LeftRadio/neil-scope3/.doc/NeilScope_v3_protocol_L.pdf

# Neil Scope 3

### формат данных и протокол обмена (data format and interface protocol)

Протокол обмена цифрового запоминающего осциллографа NeilScope v3 является полудуплексным сетевым протоколом. Обмен строится по принципу Master/Slave. Осциллограф всегда работает в режиме «Slave», отвечая на запросы программы. Запросы программы и ответы осциллографа передаются кадрами. Очередной кадр передается только после приема подтверждения на передачу предыдущего кадра.

### Структура передаваемого кадра

Передаваемый кадр имеет следующую структуру:

Признак начала кадра | Код команды | Размер кадра(*) | Данные, макс. длинна пакета Nmax = 255 | CRC8
0x5B | 8 бит | 8 бит | N * (8 бит) | 8 бит

Размер кадра включает только размер данных без кода команды и без байта контрольной суммы (CRC). Каждый посылаемый и принимаемый кадр начинается с 0x5B. Содержимое кадра представляет собой последовательность байт от 0x00 до 0xFF. Контрольная сумма представляет собой однобайтовый циклический избыточный код (CRC).

В ответ на команды программы осциллограф посылает пакет, с результатом выполнения команды:

Тип ответа

Признак
начала
кадра
| | Код ответа | Размер кадра(*) | Данные, Nmax = 256(*) | CRC8
Успешно | 0x5B | код команды + 0x40 | 8 бит | N х (8 бит) | 8 бит
Ошибка | 0x5B | 0x7F | 8 бит | 8 бит – Код ошибки | 8бит

(*) для команды запроса данных с осциллографа размер кадра состоит из 3 байт и Nmax = 262144.
Пример запроса программой 32125 точек – 0x5B 0x30 0x1F 0x5F 0x40 0x01 CRC8, где 0х30 это команда запрос данных, 0x1F 0x5F 0x40 три байта размера кадра с левым выравниванием, 0х01 – канал В.
Коды ошибок: | 0х01 | – | ошибка CRC
0x02 | – | ошибка данных
0x03 | – | команда правильная, занят, повтори

### Тайминги обмена

После запроса на инициализацию обмена хост должен выдержать паузу не менее чем 500мс перед следующим запросом, эта задержка нужна для процедуры инициализации осциллографа и перехода его к работе с ПК, в дальнейшем, перед последующими запросами выдерживать эту паузу не нужно. Ответ осциллографа на любые запросы должен прийти не позже чем через 100мс, исключение — ответ на запрос данных(см. команду Запрос данных с осциллографа), запрос перехода в режим загрузчика. После команды завершения обмена с осциллографом следующая команда с ПК, например на повторную инициализацию, не должна прийти ранее чем через 7сек.

### Расчет CRC

В расчет CRC включается содержимое кадра (байты 1…N). Кроме этого передатчик в расчет CRC включает дополнительно один нулевой байт. Приемник включает в подсчет CRC кроме содержимого кадра один байт контрольной суммы (байт N+1). При правильном приеме кадра результирующее CRC должно быть равно 0.

Алгоритм расчета CRC:
1. Значение переменной CRC приравнивается к 0x00.
2. Циклически для каждого байта, участвующего в расчете CRC, вызывается функция CRC8.
3. На вход функции CRC8 подается значение очередного байта и текущее значение CRC. Функция возвращает пересчитанное значение CRC, с учетом поданного на вход байта.
4. После вызова функции CRC8 для всех байтов на вход функции посылаем 0x00 в качестве очередного байта и текущее значение CRC
5. Получаем результирующее значение CRC.

Код используемой функции расчета CRC8

unsigned char CRC8(unsigned char byte, unsigned char crc) {
int i ;
for ( i = 0; i < 8 ; i++)
{
if (crc & 0x80) {
crc<<=1;
if (byte & 0x80) сrc = crc | 0x01;
else crc = crc & 0xfe;

crc = crc ^ 0x85;
}
else {
crc<<=1;
if (byte & 0x80) crc = crc | 0x01;
else crc = crc & 0xfe;
}
byte <<=1;
}
return (crc);
}

### Инициализация/завершение обмена

Для инициализации режима работы осциллографа совместно с программой, программа посылает на осциллограф код команды инициализации обмена и VID устройства. Получив команду, осциллограф переключается в режим управления от программы и посылает подтверждение. (см. Тайминги обмена)
После успешной инициализации программа должна сконфигурировать осциллограф - установить делители, уровень развертки, триггеров и т.д. При получении команды на завершение обмена осциллограф переключается в автономный режим работы и возвращает все параметры которые были установлены ранее в автономном режиме.

### Список управляющих команд

Значение
HEX

Комментарий

0х81 | Инициализации обмена
0хFC | Завершения обмена
0x09 | Переключение режима осциллограф / логический анализатор
0x10 | Включение/отключение аналоговых каналов и управление открытый/закрытый вход (только осциллограф)
0х11 | Управление аналоговыми делителями вертикальной развертки (только осциллограф)
0x12 | Запрос на калибровку нуля аналоговых каналов (только осциллограф)
0х14 | Режим синхронизации (только осциллограф)
0x15 | Источник триггера
0х16 | Управление типом триггера
0x17 | Уровень «UP» триггера
0x18 | Уровень «DOWN» триггера
0х19 | Управление курсором триггера по Х
0x20 | Битовая маска “перепада” триггера ЛА
0x21 | Битовая маска “состояния” триггера ЛА
0x25 | Управление горизонтальной разверткой
0x27 | Переключение режима записи - DEFAULT, MIN/MAX(только ОСЦ), INTERLIVE(только ОСЦ), RLE(только ЛА)
0x30 | Запрос данных каналов
0х0А | Запрос напряжения аккумулятора
0xEE | Запрос на сохранение всех настроек в EEPROM
0хВ0 | Запрос на переход к загрузчику
0x00 | Запрос версии прошивки

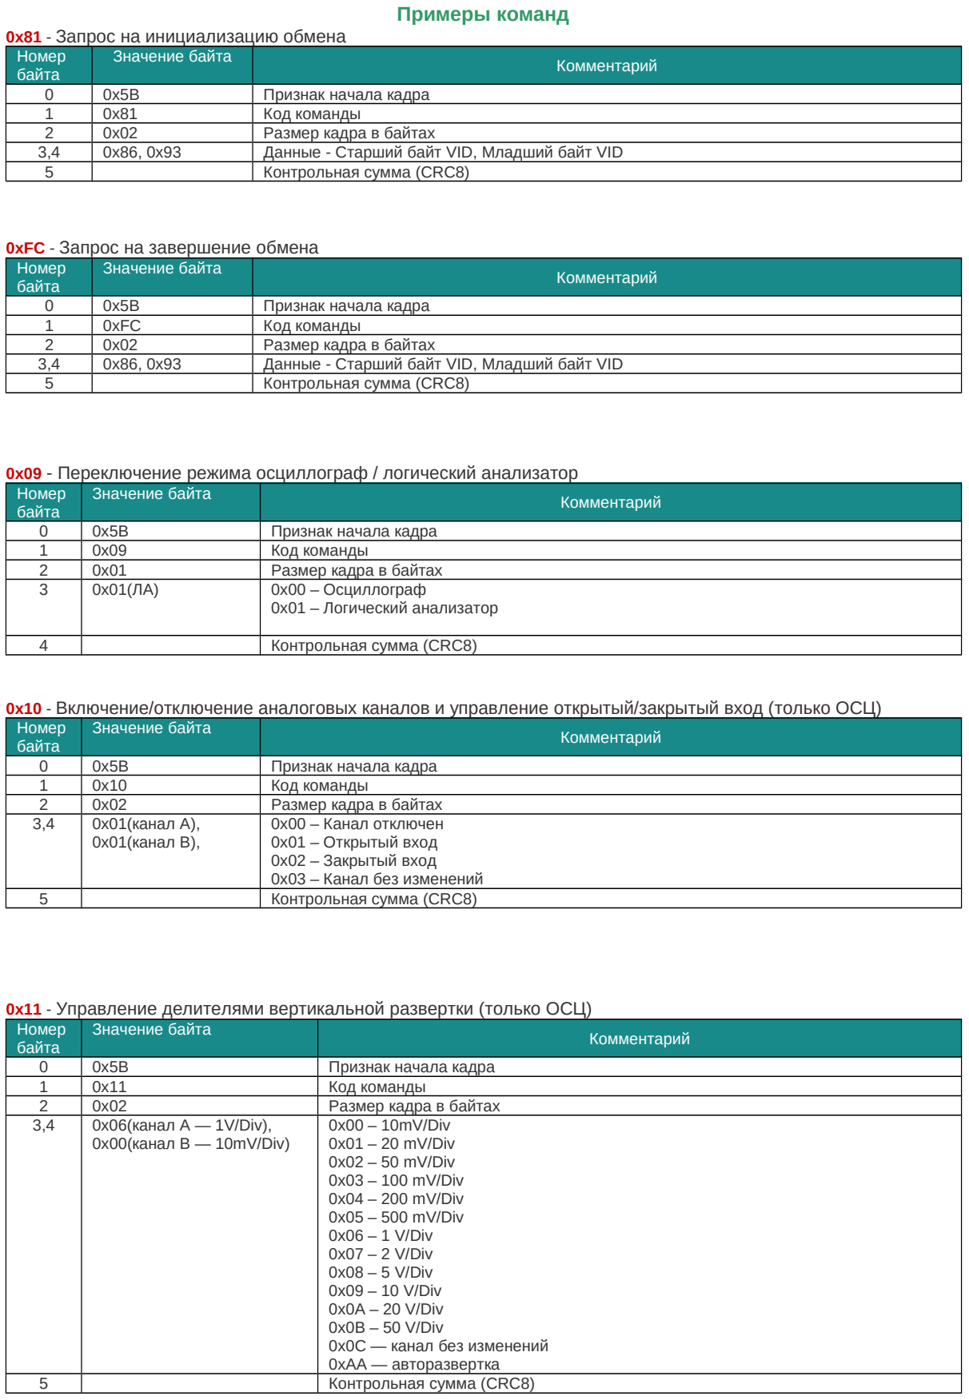
[picture p1: figure]
Примеры команд; 0х81 - Запрос на инициализацию обмена Номер байта; Значение байта; Комментарий; Признак начала кадра; Код команды; Размер кадра в байтах; Контрольная сумма (CRC8); 0хFC - Запрос на завершение обмена Номер байта; 0хFC; Номер байта; 0х00 – Осциллограф; 0х01 – Логический анализатор; 0x01(канал A),; 0x01(канал B),; 0х00 – Канал отключен 0х01 – Открытый вход 0х02 – Закрытый вход 0х03 – Канал без изменений; 0x06(канал А — 1V/Div),; 0х00(канал В — 10mV/Div)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

3,4 | 0x86, 0x93 | Данные - Старший байт VID, Младший байт VID
3,4 | 0x86, 0x93 | Данные - Старший байт VID, Младший байт VID

0x09 - Переключение режима осциллограф / логический анализатор

0x10 - Включение/отключение аналоговых каналов и управление открытый/закрытый вход (только ОСЦ)

0x11 - Управление делителями вертикальной развертки (только ОСЦ)

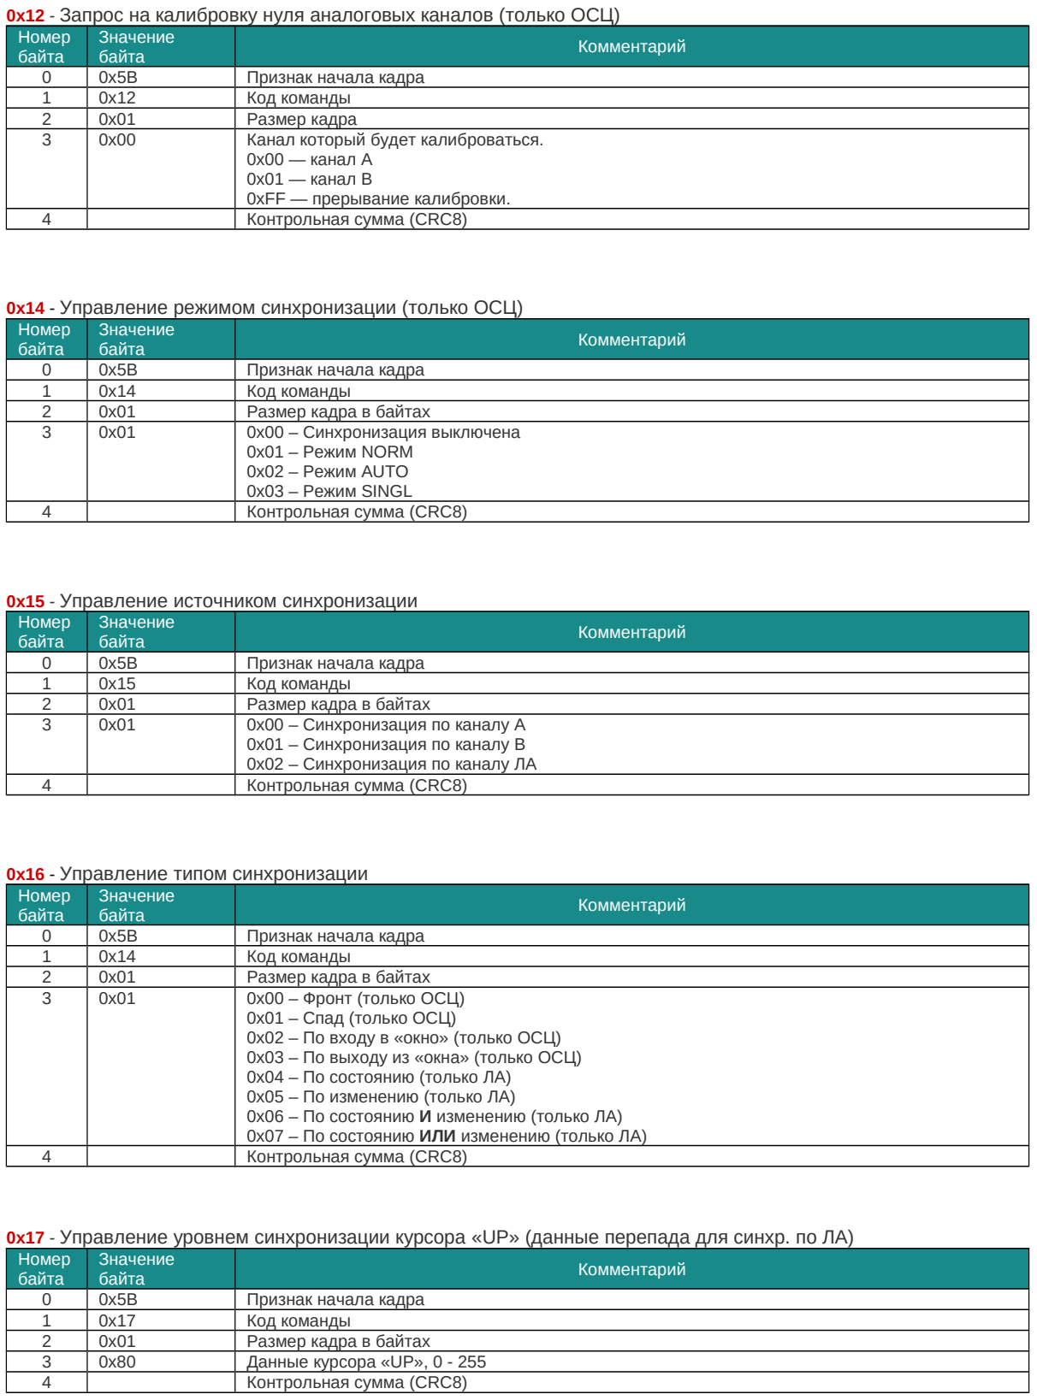
[picture p2: figure]
байта; Комментарий; Признак начала кадра; Код команды; Размер кадра; Канал который будет калиброваться.; 0х00 — канал А 0х01 — канал В 0xFF — прерывание калибровки.; Контрольная сумма (CRC8); Номер байта; Значение; Размер кадра в байтах; 0х00 – Синхронизация выключена; 0х01 – Режим NORM 0х02 – Режим AUTO 0x03 – Режим SINGL; 0x15 - Управление источником синхронизации Номер байта; 0х00 – Синхронизация по каналу A; 0х01 – Синхронизация по каналу B 0x02 – Синхронизация по каналу ЛА; 0x16 - Управление типом синхронизации Номер байта; 0х00 – Фронт (только ОСЦ)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

0x12 - Запрос на калибровку нуля аналоговых каналов (только ОСЦ)

0x14 - Управление режимом синхронизации (только ОСЦ)

0x06 – По состоянию И изменению (только ЛА) 0x07 – По состоянию ИЛИ изменению (только ЛА)

0x17 - Управление уровнем синхронизации курсора «UP» (данные перепада для синхр. по ЛА)

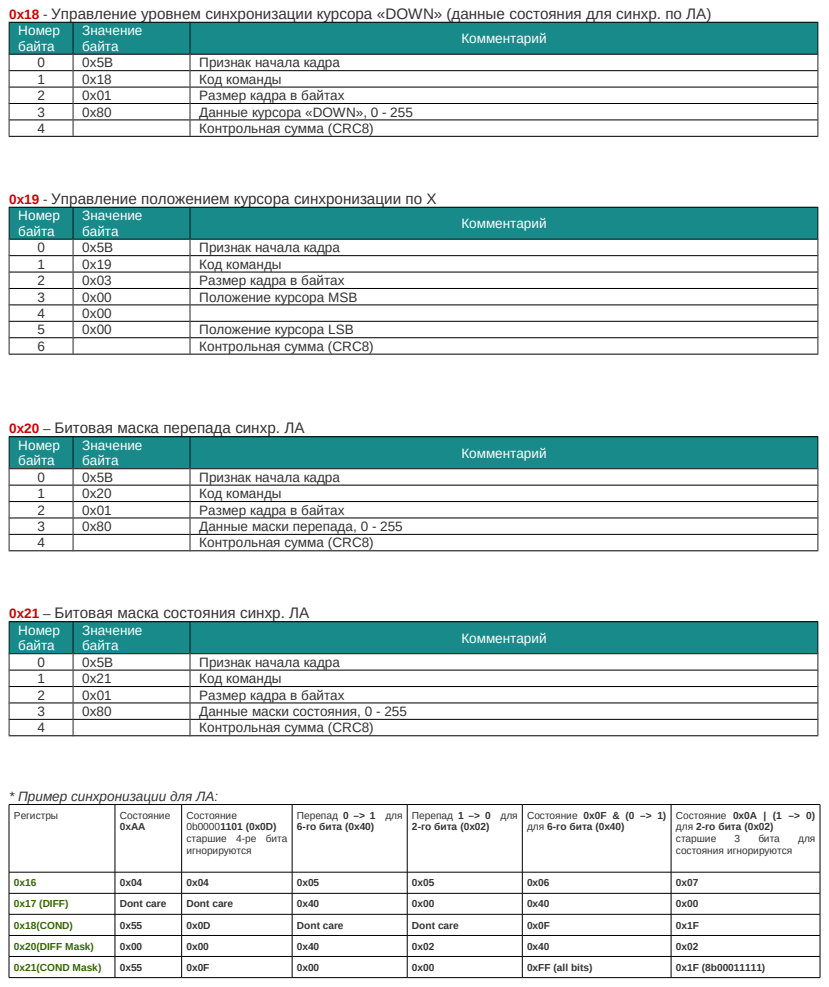
[picture p3: page 6]
Признак начала кадра; Код команды; Размер кадра в байтах; Данные курсора «DOWN», 0 - 255; Контрольная сумма (CRC8); Значение; байта; Комментарий; Положение курсора MSB; Положение курсора LSB; Данные маски перепада, 0 - 255; Данные маски состояния, 0 - 255

0x18 - Управление уровнем синхронизации курсора «DOWN» (данные состояния для синхр. по ЛА)

0x19 - Управление положением курсора синхронизации по Х
Номер
байта

0x20 – Битовая маска перепада синхр. ЛА

0x21 – Битовая маска состояния синхр. ЛА

* Пример синхронизации для ЛА:

Регистры | Состояние 0xAA | Состояние 0b00001101 (0x0D) старшие 4-ре бита игнорируются | Перепад 0 –> 1 для 6-го бита (0x40) | Перепад 1 –> 0 для 2-го бита (0x02) | Состояние 0x0F & (0 –> 1) для 6-го бита (0x40) | Состояние 0x0A | (1 –> 0) для 2-го бита (0x02) старшие 3 бита для состояния игнорируются

0x17 (DIFF) | Dont care | Dont care | 0x40 | 0x00 | 0x40 | 0x00

0x18(COND) | 0x55 | 0x0D | Dont care | Dont care | 0x0F | 0x1F

0x20(DIFF Mask) | 0x00 | 0x00 | 0x40 | 0x02 | 0x40 | 0x02

0x21(COND Mask) | 0x55 | 0x0F | 0x00 | 0x00 | 0xFF (all bits) | 0x1F (8b00011111)

0x25 - Управление делителем горизонтальной развертки

0 | 0x5B | Признак начала кадра
1 | 0x25 | Код команды
2 | 0x01 | Размер кадра в байтах
3 | 0x00 | 0x00 - 250 ns/Div (100 Msps) 0x01 - 500 ns/Div (50 Msps) 0x02 - 1 us/Div (25 Msps) 0x03 - 2 us/Div (12.5 Msps) 0x04 - 5 us/Div (5 Msps) 0x05 - 10 us/Div (2.5 Msps) 0x06 - 20 us/Div (1.25Msps) 0x07 - 50 us/Div (500 ksps) 0x08 - 100 us/Div (250 ksps) 0x09 - 200 us/Div (125 ksps) 0x0A - 500 us/Div (50 ksps)

0x0B - 1 ms/Div (25 ksps)
0x0C - 2 ms/Div (12.5 ksps) 0x0D - 5 ms/Div (5 ksps)
0x0E - 10 ms/Div (2.5 ksps) 0x0F - 20 ms/Div (1.25 ksps) 0x10 - 50 ms/Div (500 sps) 0x11 - 100 ms/Div (250 sps) 0x12 - 200ms/Div (125 sps) 0x13 - 500ms/Div (50 sps)
0x14 - 1s/Div (25 sps)
4 | Контрольная сумма (CRC8) байтов 0-3 и одного нулевого байта

0x27 - Переключение режима записи, стандарт или MIN/MAX Номер
байта

Значение
байта | Комментарий
0 | 0x5B | Признак начала кадра
1 | 0x27 | Код команды
2 | 0x01 | Размер кадра в байтах
3 | 0x00 | 0x00 - стандарт 0x01 – MIN/MAX, ( только в режиме осциллографа ) 0x02 – Режим INTERLIVE (один канал, только в режиме осциллографа ) 0x03 – Кодирование RLE ( только для ЛА )
4 | | Контрольная сумма (CRC8) байтов 0-3 и одного нулевого байта

0x30 - Запрос данных с осциллографа Номер
байта

Значение
| байта | Комментарий
0 | 0x5B | Признак начала кадра
1 | 0x30 | Код команды
2 | 0x00 | Размер кадра, старший байт
3 | 0x00 | Размер кадра, средний байт
4 | 0x01 | Размер кадра, младший байт, действительны только два старших бита этого байта, остальные
| | игнорируются
5 | 0x01 | 0х00 – Канал А
| | 0х01 – Канал В
| | 0x02 – Канал ЛА
6 | | Контрольная сумма (CRC8) байтов 0-3 и одного нулевого байта

На запрос данных осциллограф должен дать положительный ответ после сбора всех данных указанного канала. Время задержки между запросом и ответом осциллографа зависит от выбранной развертки, и количества точек для записи. Для примера:

развертка | | — 1мс/дел (деление 25 точек).
Количество точек для записи | — 1000
расчетное время ответа | — 40 мс.
развертка | | — 1сек/дел (деление 25 точек).
Количество точек для записи | — 1000
расчетное время ответа | — 40 сек.

Размер кадра имеет формат с выравниваем по старшему биту (MSB).

0xA0 - Запрос напряжения аккумулятора Номер
байта

Значение
байта | Комментарий
0 | 0x5B | Признак начала кадра
1 | 0xA0 | Код команды
2 | 0x01 | Размер кадра
3 | 0xA0 | Байт подтверждения
4 | | Контрольная сумма (CRC8) байтов 0-3 и одного нулевого байта

0xEE - Запрос на сохранение всех настроек в EEPROM

0 | 0x5B | Признак начала кадра
1 | 0xEE | Код команды
2 | 0x01 | Размер кадра
3 | 0xEE | Байт подтверждения
4 | | Контрольная сумма (CRC8) байтов 0-3 и одного нулевого байта

0xB0 - Запрос на переход к загрузчику
Номер
байта

Значение
байта | Комментарий
0 | 0x5B | Признак начала кадра
1 | 0xB0 | Код команды
2 | 0x01 | Размер кадра
3 | 0x0B | Байт подтверждения
4 | | Контрольная сумма (CRC8) байтов 0-3 и одного нулевого байта

0x00 - Запрос версии прошивки осциллографа Номер
байта

Значение
байта | Комментарий
0 | 0x5B | Признак начала кадра
1 | 0x00 | Код команды
2 | 0x01 | Размер кадра
3 | 0xFF | Байт подтверждения
4 | | Контрольная сумма (CRC8) байтов 0-3 и одного нулевого байта

0x01 - Запрос передачи версии и ID программы ПК
Номер
байта

Значение
байта | Комментарий
0 | 0x5B | Признак начала кадра
1 | 0x01 | Код команды
2 | 0x0A | Размер кадра
3 | 0х04 | Байт целой части версии софта
4 | 0х02 | Байт дробной части версии софта
5 | 0х00 | ID программы ПК
6 | | Контрольная сумма (CRC8) байтов 0-3 и одного нулевого байта
