LeftRadio/neil-scope3/.doc/BOM_NS3_rev3_2.htm

Bill Of Materials For NeilScope3
Design Title | : | NeilScope3
Author | : | Left Radio
Revision | : | 3.2
Design Created | :
Design Last Modified | :
Total Parts In Design | : | 237
90 Resistors
 | Quantity: |  | References | Value | Package
 | 1 |  | R1 | 2k | 0603
 | 1 |  | R3 | 5.6k | 0603
 | 12 |  | R4, R9, R32, R33, R55, R61, R63, R69, R70, R72, R76, R77 | 10k | 0603
 | 2 |  | R5, R44 | 499 | 0805
 | 3 |  | R6, R7, R30 | 22 | 0603
 | 2 |  | R8, R18 | 10 | 0805
 | 3 |  | R10, R11, R16 | 33 | 0603
 | 6 |  | R12, R17, R43, R49, R53, R71 | 1k | 0603
 | 2 |  | R13, R38 | 510k | 0805
 | 5 |  | R14, R20, R39, R45, R57 | 300 | 0805
 | 3 |  | R15, R52, R79 | 10k | 0805
 | 2 |  | R19, R25 | 39 | 0603
 | 2 |  | R21, R46 | 100 | 0805
 | 2 |  | R22, R47 | 49.9 | 0805
 | 2 |  | R23, R83 | 30 | 0805
 | 2 |  | R24, R84 | 20 | 0805
 | 1 |  | R26 | 0R | 1206
 | 1 |  | R27 | 3.3k | 0603
 | 2 |  | R28, R50 | 2.7k | 0603
 | 2 |  | R29, R51 | 300 | 0603
 | 2 |  | R34, R37 | 2.2k | 0603
 | 2 |  | R35, R41 | 18k | 0603
 | 2 |  | R36, R58 | 1k | 1206
 | 2 |  | R40, R48 | 33k | 0805
 | 3 |  | R54, R67, R68 | 1k | 0805
 | 2 |  | R59, R60 | 481k | 0805
 | 1 |  | R62 | 2.2 | 1206
 | 1 |  | R64 | 0 | 0805
 | 1 |  | R65 | 150k | 0603
 | 2 |  | R66, R75 | 100k | 0603
 | 2 |  | R73, R74 | 100 | 0603
 | 12 |  | R78, R80-R82, R85-R88, R90-R93 | 22 | SER RESISTOR
 | 2 |  | R94, R95 | 0R | 0603
83 Capacitors
 | Quantity: |  | References | Value | Package
 | 43 |  | C1-C10, C12, C14, C16-C18, C20-C25, C28, C29, C32-C41, C48, C49, C56, C59, C62, C71, C77, C78, C81, C82 | 100nF | 0603
 | 3 |  | C11, C67, C86 | 1uF | 0805
 | 1 |  | C13 | 4.7uF | 0603
 | 3 |  | C15, C87, C88 | 100nF | 0805
 | 6 |  | C19, C27, C47, C68, C74, C80 | 10uF | 0805
 | 1 |  | C26 | 47uF | CAPAE530X540
 | 2 |  | C30, C50 | 2.2nF | 0805
 | 2 |  | C31, C51 | 100nF | 1206
 | 2 |  | C42, C43 | 470uF | ELEC-RAD10
 | 2 |  | C44, C45 | 160pF | 0603
 | 3 |  | C46, C53, C69 | 1uF | 0603
 | 2 |  | C52, C72 | 10nF | 0603
 | 2 |  | C54, C55 | 160pF | 0805
 | 1 |  | C57 | 10uF | 1206
 | 2 |  | C58, C63 | 4.7uF | 0805
 | 2 |  | C60, C76 | 330nF | 0603
 | 1 |  | C61 | 100uF | CAPAE660X460
 | 1 |  | C64 | 47uF | TANT-B
 | 1 |  | C65 | 100uF | CAPAE430X540
 | 1 |  | C66 | 330nF | 0805
 | 1 |  | C70 | 47uF | CAPAE430X540
 | 1 |  | C73 | 100uF | TANT-B
21 Integrated Circuits
 | Quantity: |  | References | Value | Package
 | 1 |  | U1 | STM32F103RBT6B | QFP-64
 | 1 |  | U2 | KXO-V97 100.0 MHz | XO_SMT
 | 1 |  | U3 | AD9288BSTZ-100 | SQFP48-7X7
 | 2 |  | U4, U9 | 74HC4051D | SO16
 | 1 |  | U5 | CY7C1041DV33-10ZSXI | SOP80P1176X120-44
 | 1 |  | U6 | EPM570T144C5N | SQFP144-20X20
 | 2 |  | U7, U12 | CPC1035NTR | SOIC250P670X300-4
 | 2 |  | U8, U10 | AD8065ART | SOT95P270X145-5
 | 2 |  | U11, U13 | AD8129 | SO8
 | 2 |  | U14, U16 | ADP1710-3.3 | SOT23-6
 | 1 |  | U15 | 74HC4052 | TSSOP16
 | 1 |  | U17 | TPS60403 | SOT23-5
 | 1 |  | U18 | 74HC573 | TSSOP20
 | 1 |  | U19 | CP2102 | MLP-28
 | 1 |  | U20 | MCP73812 | SOT23-5
 | 1 |  | U21 | 24LC64 | SO8
6 Transistors
 | Quantity: |  | References | Value | Package
 | 1 |  | Q1 | BC847B | SOT23
 | 2 |  | Q2, Q4 | IRLML6401TR | SOT23
 | 2 |  | Q5, Q10 | IRLML2502TR | SOT23
 | 1 |  | Q11 | 2N7002 | SOT23
2 Diodes
 | Quantity: |  | References | Value | Package
 | 1 |  | D1 | LED | 0805
 | 1 |  | D2 | DL4148 | DIOMELF3414
35 Miscellaneous
 | Quantity: |  | References | Value | Package
 | 1 |  | B1 | 4.2V | CONN-SIL2
 | 1 |  | BUZ1 | BUZZER | HC09A
 | 2 |  | CX1, CX2 | 20pF | 0603
 | 6 |  | DOWN, LEFT, OK, ON1, RIGHT, UP | B3S-1000 | PUSHBUTTON1
 | 1 |  | J1 | CONN-SIL3 | CONN-SIL3M
 | 1 |  | J2 | Mini-USB | 5075BMR-05-SM
 | 1 |  | J3 | CONN-SIL6 | CONN-SIL6
 | 1 |  | J4 | CONN-SIL9 | CONN-SIL9
 | 1 |  | J5 | CONN-SIL4 | CONN-SIL4M
 | 1 |  | JP2 | JUMPER | CONN-SIL2
 | 8 |  | L1-L6, L8, L9 | BEAD | 0603
 | 1 |  | L7 | BEAD | 1206
 | 1 |  | LCD2 | EGO_3 | EGO_3.2_240400
 | 2 |  | RL1, RL2 | G6KU-2G-Y | G6KU-2F-Y
 | 1 |  | RN7 | 22 | SER RESISTOR
 | 1 |  | RX | 220 | 0603
 | 2 |  | VC1, VC3 | 10-30pF | VC TRIMMER
 | 2 |  | VC2, VC4 | 2-10pF | VC TRIMMER
 | 1 |  | X1 | 8.000MHz | XTAL18
30 ìàðòà 2015 ã. 20:17:58
