LeftRadio/neil-scope3/.doc/NS3_sch_rv3_2.pdf

# LCD 400x240 S95461B-AAA (HX8352)

U1

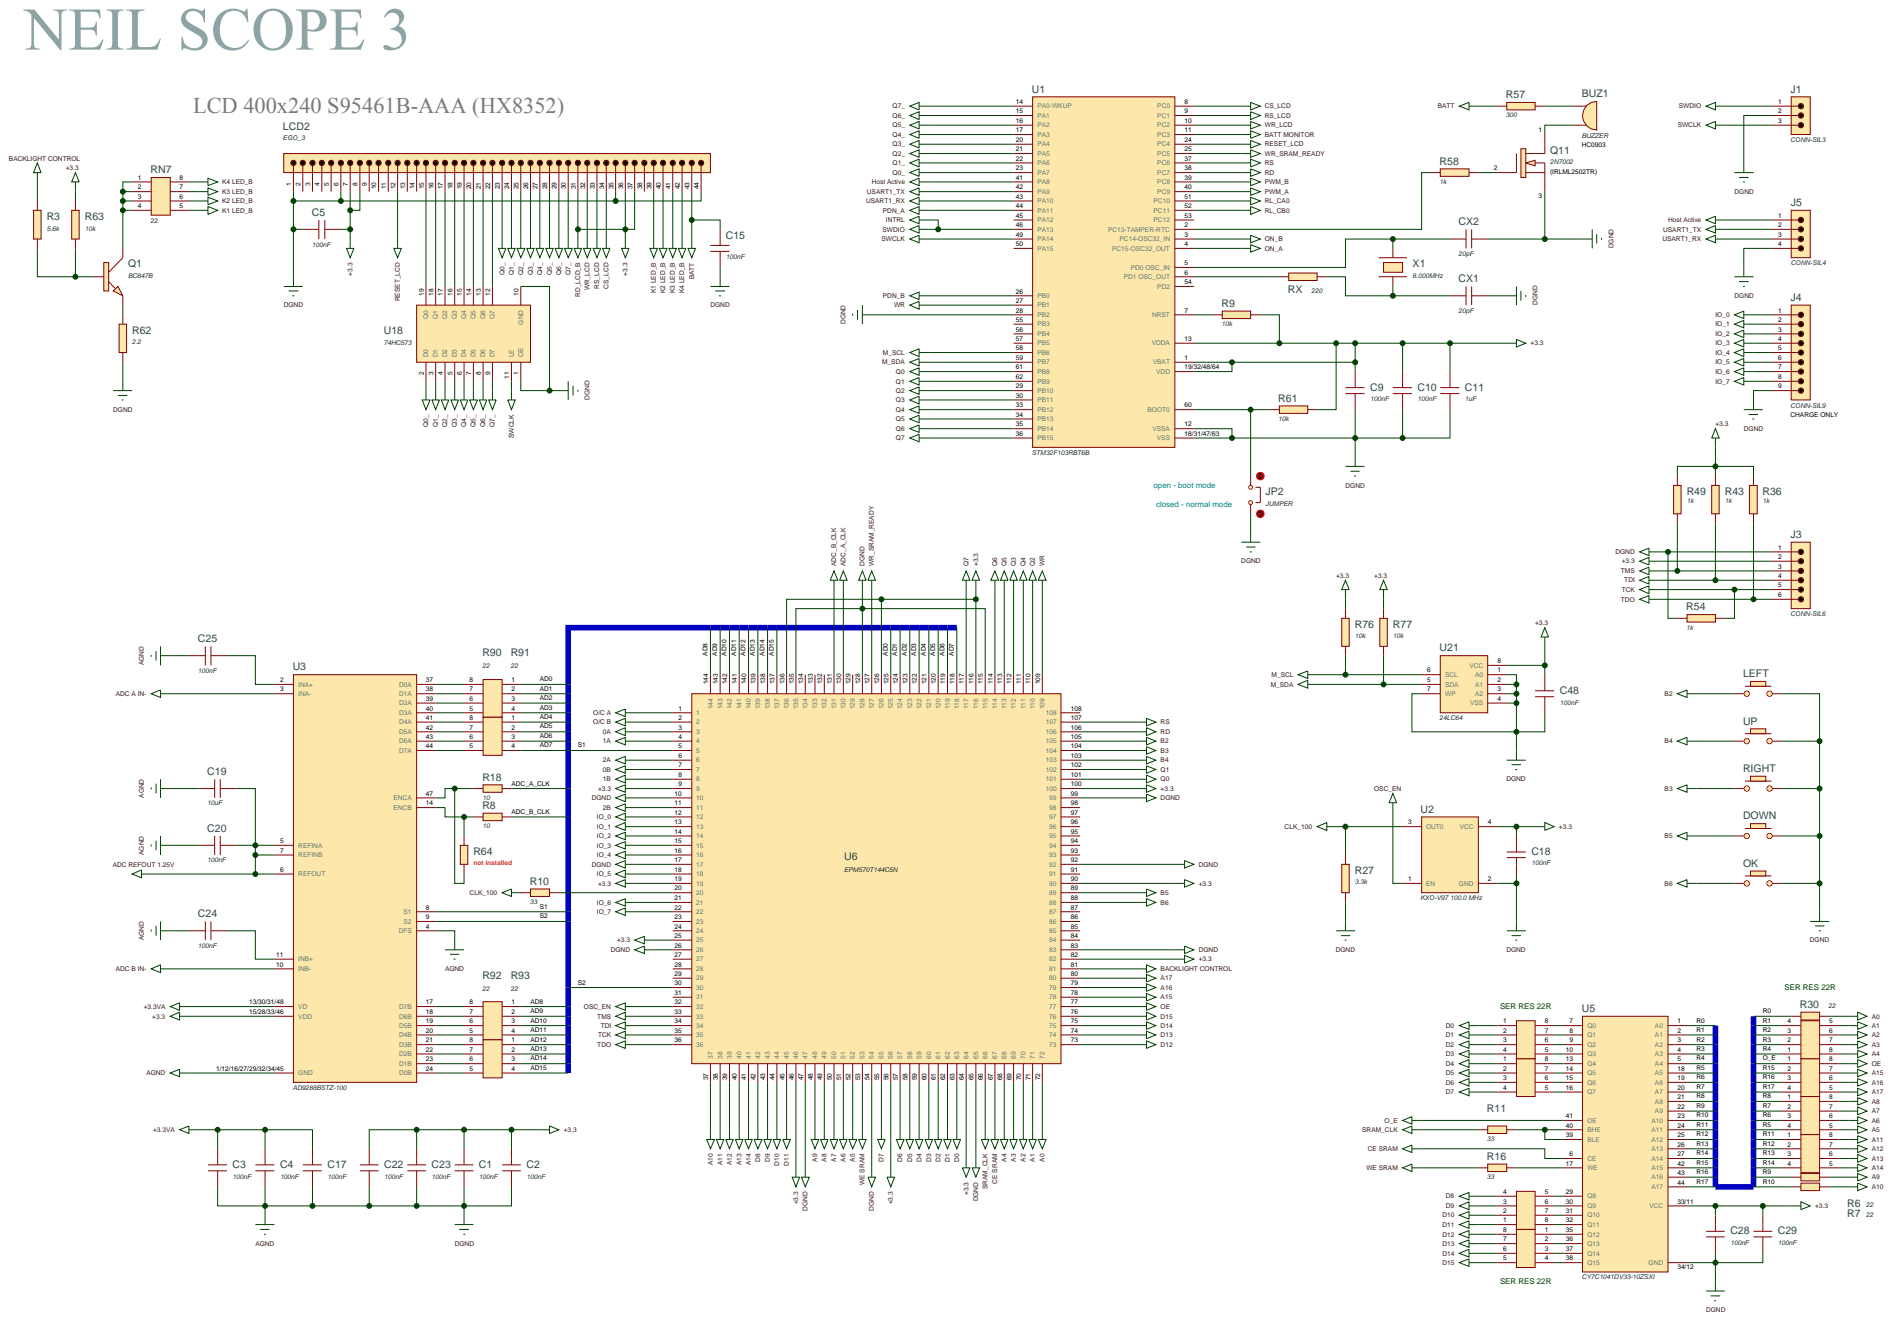
[picture p4: page 1]

C30

R13

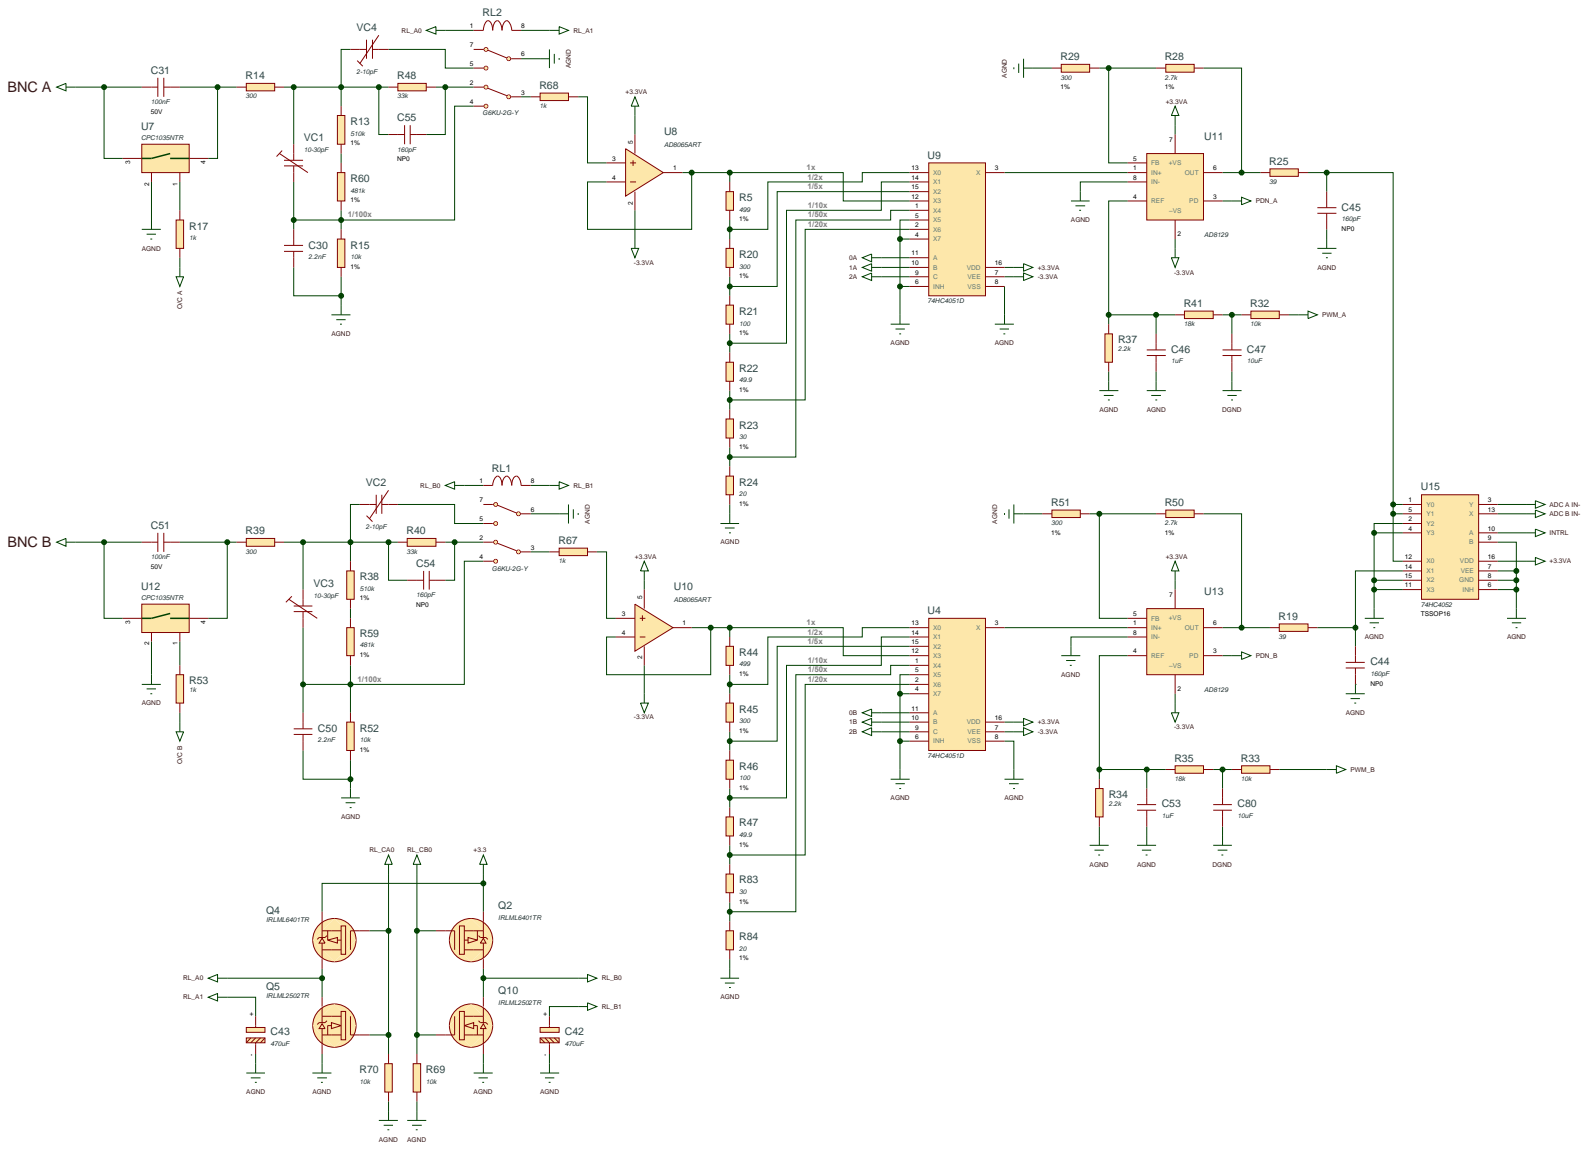
[picture p5: page 2]

R71
J2

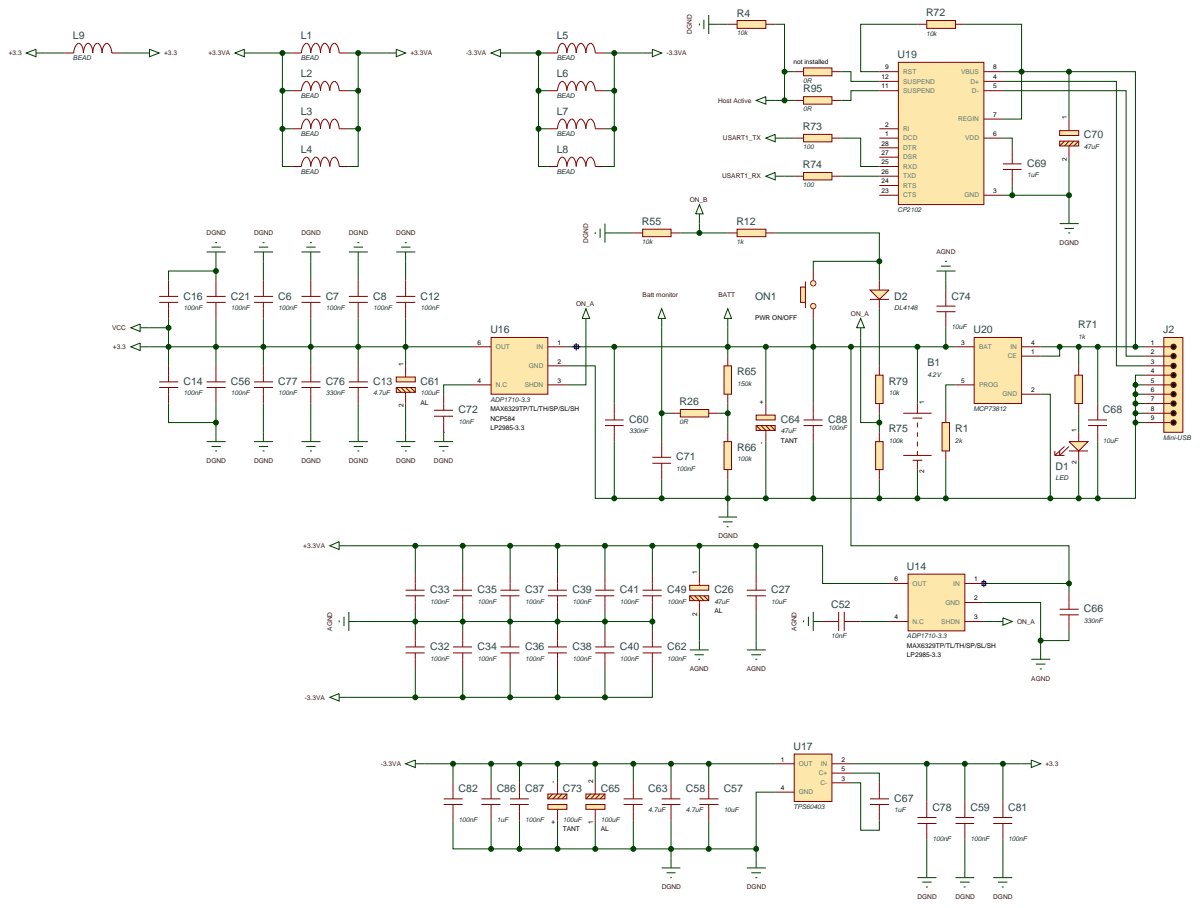
[picture p6: page 3]
