LeftRadio/neil-scope3/main.c

/**
  ******************************************************************************
  * @file	 	main.c
  * @author  	Left Radio
  * @version 	1.5.6
  * @date
  * @brief		NeilScope3 Main sourse
  ******************************************************************************
**/

/* Includes ------------------------------------------------------------------*/
#include "stm32f10x.h"
#include "defines.h"
#include "main.h"
#include "init.h"
#include "Settings.h"
#include "systick.h"
#include "User_Interface.h"
#include "EPM570.h"
#include "Synchronization.h"
#include "Processing_and_output.h"
#include "Host.h"
#include "IQueue.h"
#include "i2c_gpio.h"

/* Private typedef -----------------------------------------------------------*/
/* Private define ------------------------------------------------------------*/
/* Private macro -------------------------------------------------------------*/
/* Private variables ---------------------------------------------------------*/
uint8_t i;
uint8_t IQueue_WorkIndex = 0;
FunctionalState VisibleDigitSyncChannel = DISABLE;
FlagStatus show_FPS_flag = RESET;
uint8_t FPS_counter = 0;
float temp = 0;
uint8_t t_WorkMinutes = 0;

/* Global work mode for device */
__IO OscMode_TypeDef gOSC_MODE =
{
	388,				// Number points to write SRAM
	OSC_MODE,			// Oscilloscope or LogicAnalyzer work mode state
	FALSE,				// Interleave mode state
	OFF,				// Automeasurments state
	PWR_S_DISABLE,		// Power save mode state
	BCKL_MAX,
	0,					// external i2c ports chip
	Host_CP2102_Mode,	// Host communicate type
	ENABLE,				// Beeper state
	RUN,				// Work state
	FALSE				// Configure state
};

/*  */
__IO SamplesWin_Typedef gSamplesWin = {
		388,			// Sample 1 window width
		0,				// Active window position
		1,				// Windows number in gOSC_MODE.NumPoints
		0,				// Horizontal scale coefficient
};

/* Timer for auto OFF power when Vbatt is less the 3.45V, or manual OFF timeout */
OFF_Struct_TypeDef AutoOff_Timer = {
		0,			// Reset(start counting) time
		0,			// OFF time
		0,			// Batt low voltage flag
		DISABLE,	// Auto OFF State
};

extern btnINFO btnRUN_HOLD;
extern Boolean USB_CP2102_Connect_Event;
extern const char btnHostMode_Texts[5][19];

/* Extern function -----------------------------------------------------------*/
extern FlagStatus ADC_Ready(void);
void setCondition(uint8_t RUN_HOLD);
void (*pMNU)(void) = Change_Menu_Indx;     /* указатель на функцию меню */

/* Private function prototypes -----------------------------------------------*/
static void Host_Communicate_USBEvent(void);

/* Private Functions --------------------------------------------------------*/

/**
 * @brief  main cycle
 * @param  None
 * @retval None
 */
int main(void)
{
	__disable_irq();

	/* Init internal and external peripheal */
	Global_Init();

	/* Init and verify external peripheal */
	External_Peripheral_Init();

	/* Load preference from EEPROM */
	LoadPreference();

	/* Default/Saved host communicate state configure */
	Host_Comunication_Configuration(
			(NS_Host_Communicate_TypeDef*)&gOSC_MODE.HostCommunicate
	);

	/* Draw main interface */
	Draw_Interface();

	/* other */
	EPM570_Set_LA_RLE_State(DISABLE);
	GPIOC->BRR = GPIO_Pin_13;

	gOSC_MODE.Configurated = TRUE;

	NVIC_EnableIRQ(RTC_IRQn);
	__enable_irq();


	/* Main work */
	while(1)
	{

#ifndef __SWD_DEBUG__
		if(gOSC_MODE.PowerSave == PWR_S_ENABLE)	__WFI();
#endif

		// Check USB interrupt event
		Host_Communicate_USBEvent();

//		if(Host_IQueue_Get_CommandsCount() > 0)	{
			for(i = 0; i < IQUEUE_SIZE; i++) {
				if(Host_GetIQueue(i)->IsEmpty == FALSE) {
					Recive_Host_Data(i);
					Host_IQueue_Clear(i);
//					Host_IQueue_SetCommandCount(-1);
				}
			}
//		}


		if(HostMode != ENABLE)
		{
			UpdateAllCursors();

			/* Накапливаем, обрабатываем и выводим данные осциллограмм */
			INFO_A.Procesing(INFO_A.Mode);
			INFO_B.Procesing(INFO_B.Mode);

			/* Если режим однократной развертки то останавливаемся до перезапуска */
			if((gSyncState.Mode == Sync_SINGL) && (gOSC_MODE.State == RUN) && (EPM570_SRAM_GetWriteState() == COMPLETE))
			{
				setCondition(STOP);
			}

			/* если были нажаты какие либо кнопки, то переходим в функцию
		 	   на которую сейчас указывает void (*pMNU)(void).
			--- Опрос кнопок происходит через чтение регистра ПЛИС по прерыванию таймера TIM2 --- */
			if(ButtonPush != B_RESET){ pMNU(); ButtonPush = B_RESET; ButtonsCode = NO_Push; }


			/* подсчет и отображение кадров/сек. */
			if(show_FPS_flag == SET){ UI_ShowFPS(FPS_counter); FPS_counter = RESET; }
			else FPS_counter++;

			/* обновление уровня заряда */
			if(show_ADC_flag == SET)
			{
				if(ADC_VbattPrecent <= 0)
				{
					if(AutoOff_Timer.Vbatt != 1)
					{
						gMessage.TimeShow = 60;
						Show_Message("Connect Cargher, auto off in 1 min");
						t_WorkMinutes = AutoOff_Timer.Work_Minutes;
						AutoOff_Timer.ResetTime = RTC_GetCounter();
						AutoOff_Timer.Vbatt = 1;
						AutoOff_Timer.Work_Minutes = 1;
						AutoOff_Timer.State = ENABLE;
						Draw_Batt(1, 1);
					}
				}
				else
				{
					if(AutoOff_Timer.Vbatt == 1)
					{
						AutoOff_Timer.Vbatt = 0;
						gMessage.TimeShow = 1;

						Clear_Message();

						AutoOff_Timer.ResetTime = RTC_GetCounter();
						AutoOff_Timer.Work_Minutes = t_WorkMinutes;
						AutoOff_Timer.State = DISABLE;
					}

					Draw_Batt(ADC_VbattPrecent, 1);
				}

				show_ADC_flag = RESET;
			}

			/* Message event */
			if(MessageEvent == SET){ Clear_Message(); MessageEvent = RESET;	}
		}
	}
}

/**
 * @brief  Host_Communicate_USBEvent
 * @param  None
 * @retval None
 */
static void Host_Communicate_USBEvent(void)
{
	static NS_Host_Communicate_TypeDef communicate_saved_state = 255;
	char* ext_message;

	if (USB_CP2102_Connect_Event == TRUE) {

		USB_CP2102_Connect_Event = FALSE;

		if ((gOSC_MODE.HostCommunicate == Host_ESP_Mode) || (communicate_saved_state == Host_ESP_Mode)) {
			if(GPIO_ReadInputDataBit(GPIOA, GPIO_Pin_8) == Bit_RESET) {
				if (communicate_saved_state != 255) {
					gOSC_MODE.HostCommunicate = communicate_saved_state;
				}
				else {
					communicate_saved_state = gOSC_MODE.HostCommunicate;
				}
				ext_message = "USB DisConnected, Host mode Restore";
			}
			else {
				communicate_saved_state = gOSC_MODE.HostCommunicate;
				gOSC_MODE.HostCommunicate = Host_OFF;

				ext_message = "USB Connected, Host OFF";
			}

			Host_Comunication_Configuration(
					(NS_Host_Communicate_TypeDef*)&gOSC_MODE.HostCommunicate
			);

			Show_Message(ext_message);
			delay_ms(1000);
			ext_message = (char*)btnHostMode_Texts[gOSC_MODE.HostCommunicate];
			Show_Message(ext_message);
		}
	}
}

/**
 * @brief  setCondition, global work state - RUN or HOLD
 * @param  None
 * @retval None
 */
void setCondition(State_TypeDef NewState)
{
	static Boolean pwr;

	/* Switch to power save in STOP work state */
	if(NewState == STOP)
	{
		pwr = gOSC_MODE.PowerSave;
		gOSC_MODE.PowerSave = TRUE;

		/* Update button RUN/HOLD */
		btnRUN_HOLD.Text = "STOP";
	}
	else
	{
		if(gOSC_MODE.State == STOP) gOSC_MODE.PowerSave = pwr;

		/* Update button RUN/HOLD */
		btnRUN_HOLD.Text = "RUN";
	}

	/* Set the new global work state */
	gOSC_MODE.State = NewState;

	if(btn == &btnRUN_HOLD)	LCD_DrawButton(&btnRUN_HOLD, activeButton);
	else LCD_DrawButton(&btnRUN_HOLD, NO_activeButton);
}




/*********************************************************************************************************
      END FILE
*********************************************************************************************************/
