LeftRadio/neil-scope3/drivers/i2c/i2c_gpio/i2c_gpio.h

/**
  ******************************************************************************
  * @file	 	i2c_gpio.h
  * @author  	Left Radio
  * @version	1.0.0
  * @date
  * @brief		header
  ******************************************************************************
**/

/* Define to prevent recursive inclusion -------------------------------------*/
#ifndef __NS_I2C_GPIO__H
#define __NS_I2C_GPIO__H

/* Includes ------------------------------------------------------------------*/
#include "main.h"

/* Exported define -----------------------------------------------------------*/
/* Exported macro ------------------------------------------------------------*/
/* Exported typedef ----------------------------------------------------------*/
/* */
typedef struct {
	uint8_t i2c_address;
	int8_t (*Configuration)(void);
	int8_t (*Write_Pin)(uint32_t pin, uint8_t state);
	int8_t (*Write_Port)(uint32_t val);
	int8_t (*Read_Pin)(uint32_t pin);
	int8_t (*Read_Port)(void* data);
} NS_I2C_GPIO_TypeDef;

/* Exported variables --------------------------------------------------------*/
//extern NS_I2C_GPIO_TypeDef pca9675;
//extern NS_I2C_GPIO_TypeDef max7320;

extern NS_I2C_GPIO_TypeDef* ns_i2c_gpios[];

/* Exported function ---------------------------------------------------------*/
int8_t I2CIO_Configuration(NS_I2C_GPIO_TypeDef* gpio);
void I2CIO_Write_Pin(uint32_t pin, uint8_t state);
void I2CIO_Write_Port(uint32_t val);
int8_t I2CIO_Read_Pin(uint32_t pin);
void I2CIO_Read_Port(void* data);



#endif /* __NS_I2C_GPIO__H */
/*********************************************************************************************************
      END FILE
*********************************************************************************************************/
