LeftRadio/neil-scope3/drivers/i2c/i2c.h

/**
  ******************************************************************************
  * @file	 	i2c.h
  * @author  	Left Radio
  * @version 	1.0.0
  * @date
  * @brief		NeilScope3 i2c Write/Read header
  ******************************************************************************
**/

#ifndef _NI2C__H
#define _NI2C__H

/* Includes ------------------------------------------------------------------*/
/* Exported types ------------------------------------------------------------*/
/* Exported constants --------------------------------------------------------*/
/* Exported define -----------------------------------------------------------*/
/* Exported variables --------------------------------------------------------*/
/* Exported macro ------------------------------------------------------------*/
/* Exported functions ------------------------------------------------------- */
int8_t I2C_Write_Bytes(uint8_t *Data, uint8_t len, uint8_t i2c_address);
int8_t I2C_Read_Bytes(uint8_t *Data, uint8_t len, uint8_t i2c_address);



#endif /* _NI2C__H */
/*********************************************************************************************************
      END FILE
*********************************************************************************************************/
