LeftRadio/neil-scope3/defines.h

/**
  ******************************************************************************
  * @file	 	defines.h
  * @author  	Left Radio
  * @version
  * @date
  * @brief		header
  ******************************************************************************
**/

/* Define to prevent recursive inclusion -------------------------------------*/
#ifndef _DEFINES__H
#define _DEFINES__H

/* Includes ------------------------------------------------------------------*/
/* Exported define -----------------------------------------------------------*/
#define __FIRMWARE_VERSION__			((uint8_t)(59)) //$59
#define __FIRMWARE_REVISION__			"A"             //$A

/* Debug defines */
#ifdef __SWD_DEBUG__
	#ifndef __POWER_BUTTON_OFF__
		#define __POWER_BUTTON_OFF__
	#endif
#endif

/* Exported macro ------------------------------------------------------------*/
/* Exported typedef ----------------------------------------------------------*/
/* Exported variables --------------------------------------------------------*/
/* Exported function ---------------------------------------------------------*/




#endif /* _DEFINES__H */
/*********************************************************************************************************
      END FILE
*********************************************************************************************************/
