LeftRadio/neil-scope3/drivers/analog/AutoCorrectCH.h

/*************************************************************************************
*
Description :  NeilScope3 Auto Correction header
Version     :  1.0.0
Date        :  7.12.2011
Author      :  Left Radio                          
Comments    :  
*
**************************************************************************************/

#ifndef __AUTO_CORRECT_H
#define __AUTO_CORRECT_H 

/* Includes ------------------------------------------------------------------*/	   
/* Exported typedef -----------------------------------------------------------*/
/* Exported define -----------------------------------------------------------*/
/* Exported variables --------------------------------------------------------*/
/* Private function prototypes -----------------------------------------------*/
/* Exported function --------------------------------------------------------*/
void Auto_CorrectZ_CH_A(void);
void Auto_CorrectZ_CH_B(void);
int8_t Auto_CorrectZ_CH(uint8_t Channel);

#endif /* __AUTO_CORRECT_H */
/*********************************************************************************************************
      END FILE
*********************************************************************************************************/
