LeftRadio/neil-scope3/drivers/esp_07/ns_esp_07.h

/**
  ******************************************************************************
  * @file	 	ns_esp_07.h
  * @author  	Left Radio
  * @version	1.0.0
  * @date
  * @brief		header
  ******************************************************************************
**/

/* Define to prevent recursive inclusion -------------------------------------*/
#ifndef __NS_ESP_07__H
#define __NS_ESP_07__H

/* Includes ------------------------------------------------------------------*/
#include "main.h"
#include "i2c_gpio.h"

/* Exported define -----------------------------------------------------------*/
/* Exported macro ------------------------------------------------------------*/
/* Exported typedef ----------------------------------------------------------*/
/* Exported variables --------------------------------------------------------*/
/* Exported function ---------------------------------------------------------*/

int ESP_State_Host_MCU(void);
int ESP_State_Interconnect_CP2102(void);
int ESP_State_Bootloader(void);
int ESP_State_OFF(void);


#endif /* __NS_ESP_07__H */
/*********************************************************************************************************
      END FILE
*********************************************************************************************************/
