LeftRadio/neil-scope3/interface/Advanced_Menu.h

/**
  ******************************************************************************
  * @file	 	Advanced_Menu.h
  * @author  	Left Radio
  * @version 	1.0.0
  * @date
  * @brief		NeilScope3 Advanced Menu header
  ******************************************************************************
**/

#ifndef __ADVANCED_MENU_H
#define __ADVANCED_MENU_H

/* Includes ------------------------------------------------------------------*/	   
#include "HX8352_Library.h"

/* Exported typedef -----------------------------------------------------------*/
/* Exported define -----------------------------------------------------------*/
/* Exported variables --------------------------------------------------------*/
//extern FunctionalState  VisibleQuickMenu;
//extern btnINFO Interpolation, BeepEN, AutoPowerOFF;
//extern char AutoPowerOFF_btnTxt[13];

/* Private function prototypes -----------------------------------------------*/
/* Exported function --------------------------------------------------------*/


#endif /* __ADVANCED_MENU_H */
/*********************************************************************************************************
      END FILE
*********************************************************************************************************/
