LeftRadio/neil-scope3/drivers/i2c/i2c_gpio/max7320.h

/**
  ******************************************************************************
  * @file	 	max7320.h
  * @author  	Left Radio
  * @version	1.0.0
  * @date
  * @brief		header
  ******************************************************************************
**/

/* Define to prevent recursive inclusion -------------------------------------*/
#ifndef __NS_MAX7320_GPIO__H
#define __NS_MAX7320_GPIO__H

/* Includes ------------------------------------------------------------------*/
#include "i2c_gpio.h"

/* Exported define -----------------------------------------------------------*/
/* Exported macro ------------------------------------------------------------*/
/* Exported typedef ----------------------------------------------------------*/
extern NS_I2C_GPIO_TypeDef max7320;

/* Exported variables --------------------------------------------------------*/
/* Exported function ---------------------------------------------------------*/




#endif /* __NS_MAX7320_GPIO__H */
/*********************************************************************************************************
      END FILE
*********************************************************************************************************/
