LeftRadio/neil-scope3/interface/Digit_Trig_Menu.h

/*************************************************************************************
*
Description :  NeilScope3 Digit Trig Menu header
Version     :  1.0.0
Date        :  25.04.2012
Author      :  Left Radio                          
Comments    :  
*
**************************************************************************************/

#ifndef __DIGIT_TRIG_MENU_H
#define __DIGIT_TRIG_MENU_H 

/* Includes ------------------------------------------------------------------*/	   
/* Exported typedef -----------------------------------------------------------*/
/* Exported define -----------------------------------------------------------*/

/* Exported variables --------------------------------------------------------*/
/* Private function --------------------------------------------------------*/
/* Exported function --------------------------------------------------------*/
static void Change_Digit_Trig_Menu(void);


#endif /* __DIGIT_TRIG_MENU_H */
/*********************************************************************************************************
      END FILE
*********************************************************************************************************/
