LeftRadio/neil-scope3/interface/TimeScale_Menu.h

/*************************************************************************************
*
Description :  NeilScope3 Time Scale Menu header
Version     :  1.0.0
Date        :  7.12.2011
Author      :  Left Radio
Comments    :
*
**************************************************************************************/

#ifndef __TIME_SCALE_MNU_H
#define __TIME_SCALE_MNU_H

/* Includes ------------------------------------------------------------------*/
#include "HX8352_Library.h"

/* Exported typedef -----------------------------------------------------------*/
/* Exported define -----------------------------------------------------------*/
/* Exported variables --------------------------------------------------------*/
/* Private function prototypes -----------------------------------------------*/
/* Exported function --------------------------------------------------------*/
void Draw_TimeScale_Menu(DrawState NewDrawState);
void Reset_TimeScale_Menu(void);
void TimeScale_Menu(void);

#endif /* __TIME_SCALE_MNU_H */
/*********************************************************************************************************
      END FILE
*********************************************************************************************************/
