LeftRadio/neil-scope3/(commit log)

2015-05-24 refract
    fixes bugs and some refract code
    [Analog.c, Analog.h, AutoCorrectCH.c, ChannelsMenu.c, Digit_Trig_Menu.c, EPM570.c]
2015-12-04 Add I2C external GPIO (NXP PCA9675)
2018-02-10 fix upper case includes/filenames for linux build
    [main.c, ns_esp_07.c]
